turfster1/Spi2i2c2020-/images/DAUGHTERBOARD REV. 7 GREG VERSION.jpg

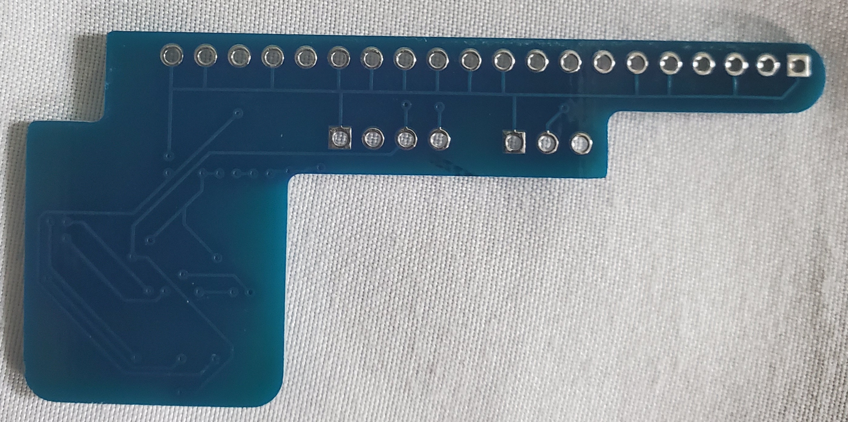
images/DAUGHTERBOARD REV. 7 GREG VERSION.jpg
