turfster1/Spi2i2c2020-/README.md

# Spi2i2c2020-
Open source recreation of the spi2par. However this new board  allows you to use slim character oled us2066 on the Xenium modchip for the OG Xbox. 

Thanks to everyone that helped.

This is for all original xbox enthusiasts to enjoy.

More to come soon.
