turfster1/Spi2i2c2020-/Arduinium/3D_New Arduinium 4 layer_2023-01-01emojiback.png

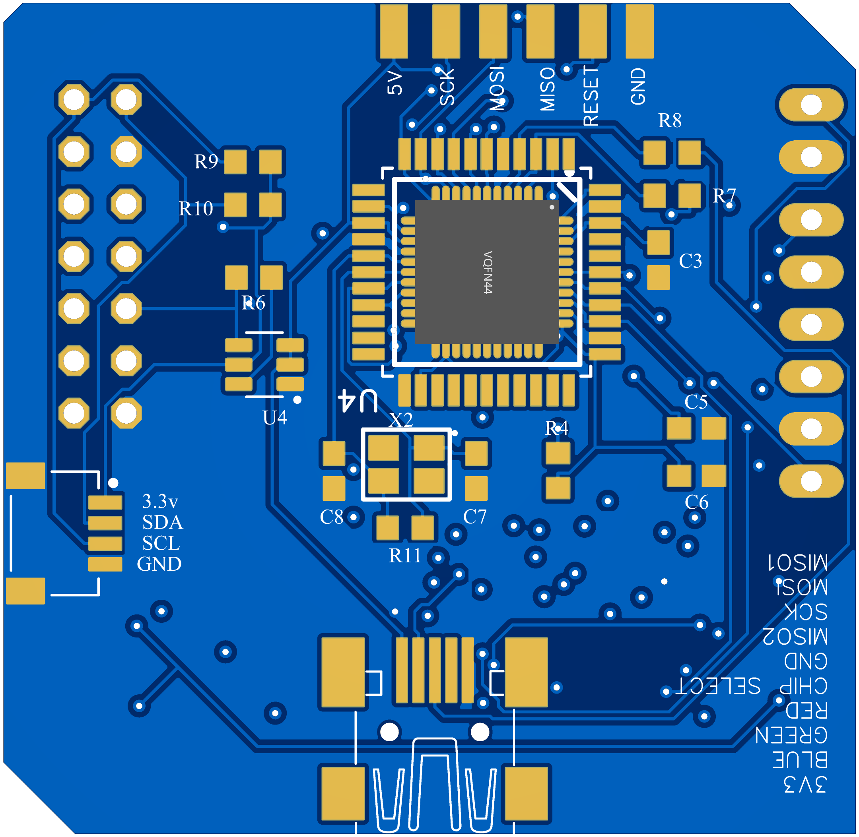
Arduinium/3D_New Arduinium 4 layer_2023-01-01emojiback.png
