turfster1/Spi2i2c2020-/Arduinium/Pics/3D_New Arduinium 4 layer_2023-01-01.png

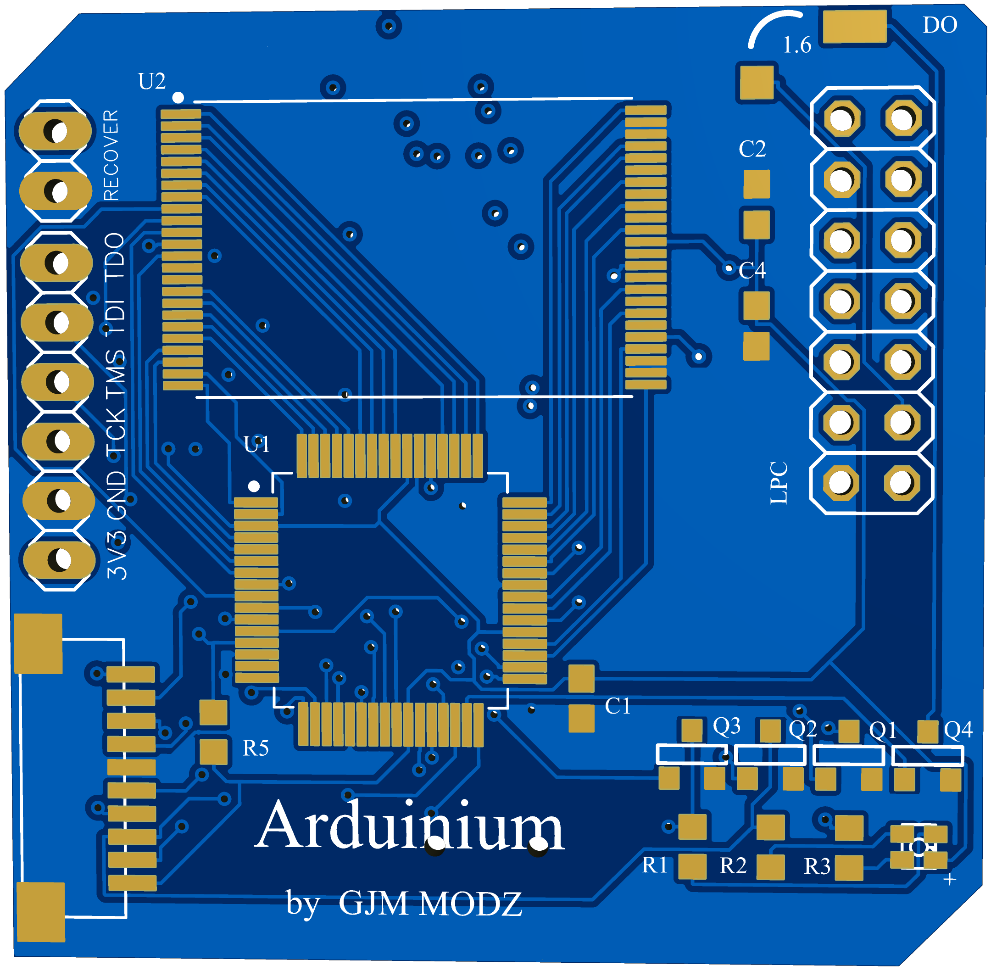
Arduinium/Pics/3D_New Arduinium 4 layer_2023-01-01.png
