turfster1/Spi2i2c2020-/Arduinium/Pics/3D_New Arduinium 4 layer_2024-02-11back.png

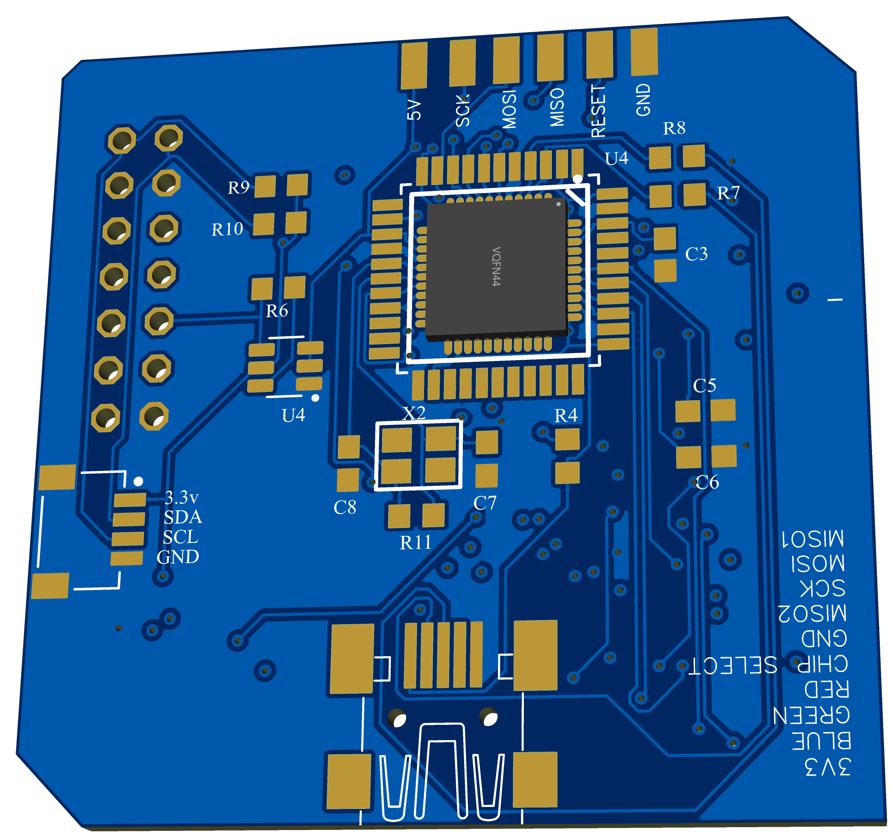
Arduinium/Pics/3D_New Arduinium 4 layer_2024-02-11back.png
