turfster1/Spi2i2c2020-/images/20201115_141857.jpg

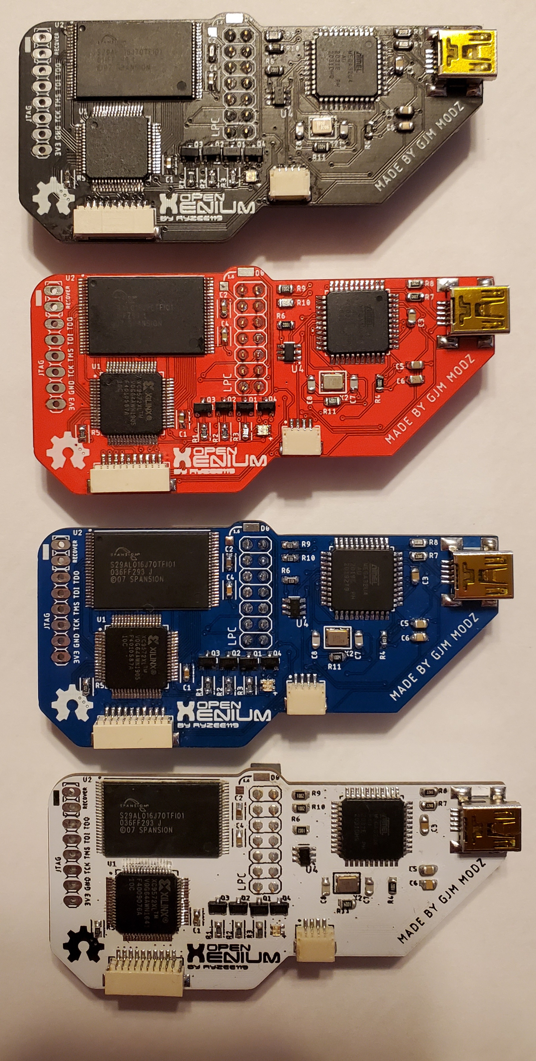
images/20201115_141857.jpg
