turfster1/Spi2i2c2020-/images/received_360769395019005.jpeg

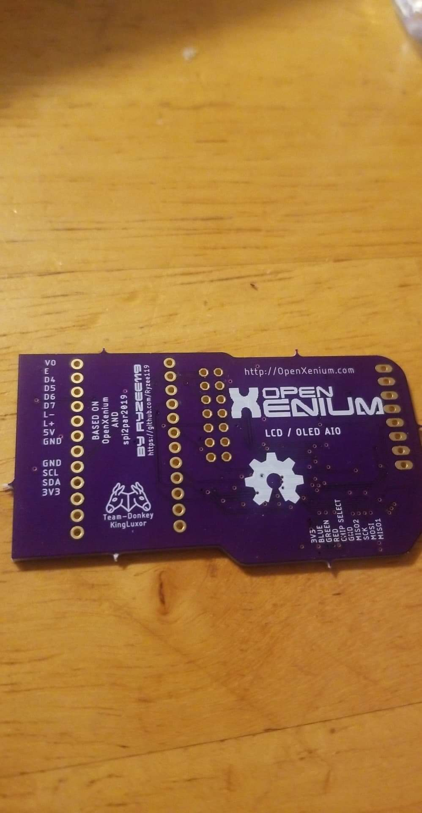
images/received_360769395019005.jpeg
