turfster1/Spi2i2c2020-/images/received_1338122879872721.jpeg

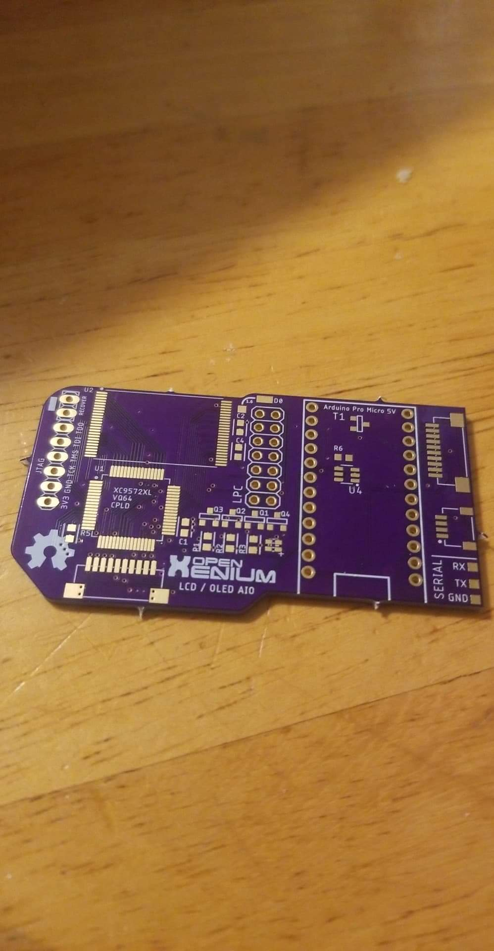
images/received_1338122879872721.jpeg
