turfster1/Spi2i2c2020-/images/VIRGIL PROOF THIS SIDE UP.jpg

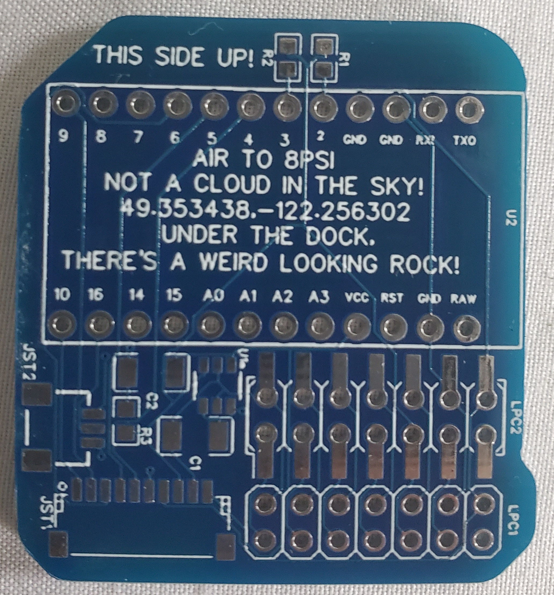
images/VIRGIL PROOF THIS SIDE UP.jpg
