turfster1/Spi2i2c2020-/images/VIRGIL PROOF.jpg

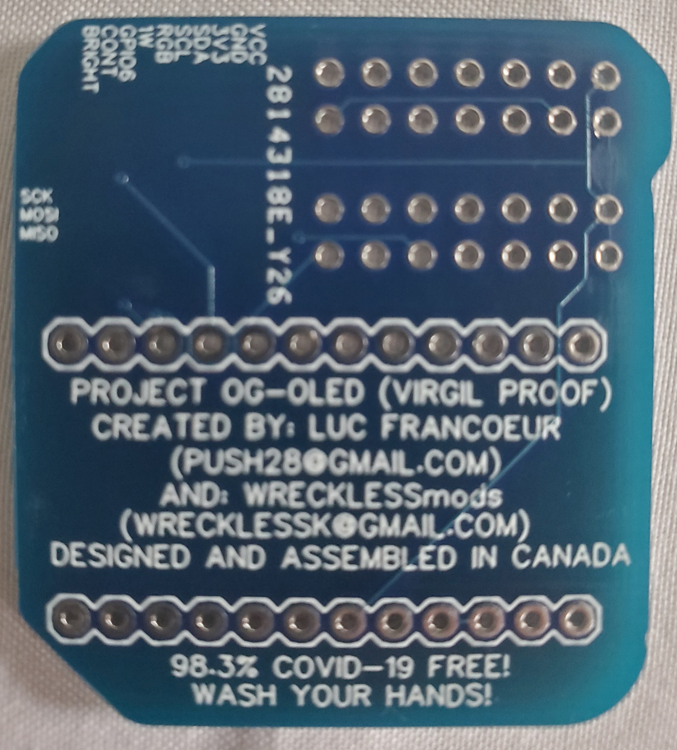
images/VIRGIL PROOF.jpg
