turfster1/Spi2i2c2020-/Oled Openxenium V1/Pics/top.png

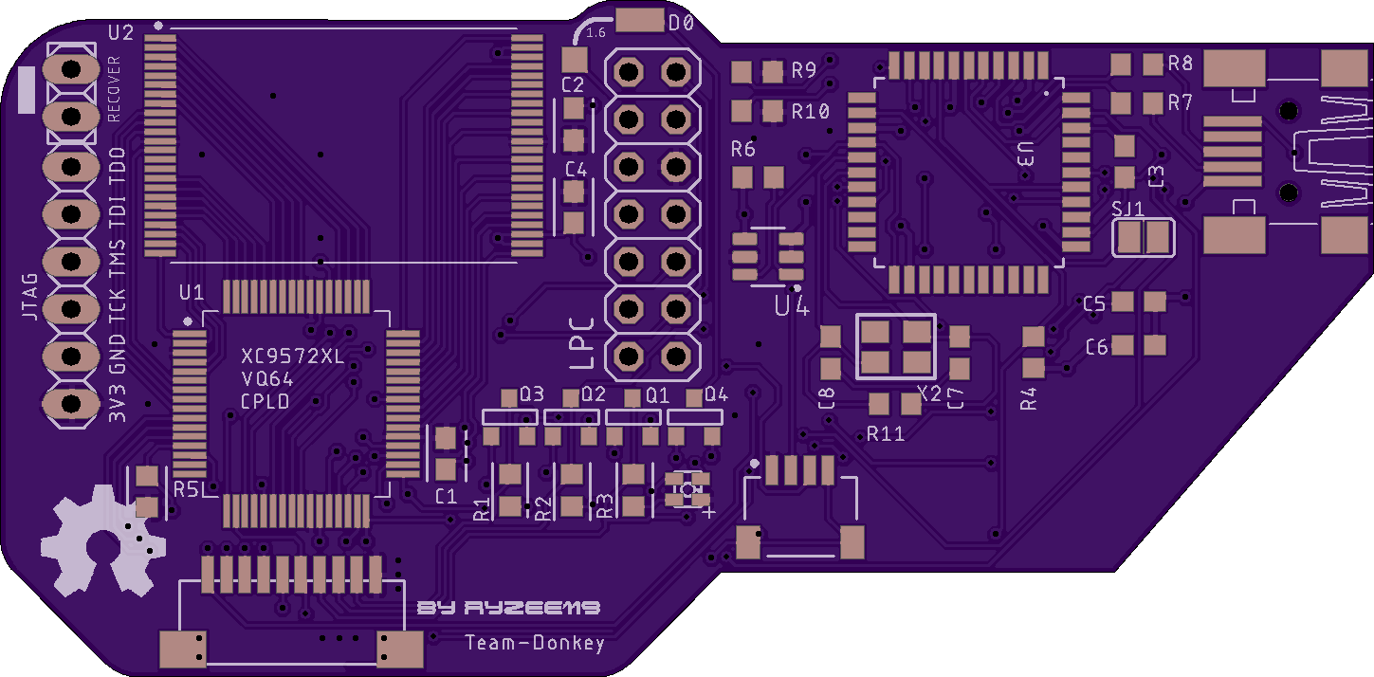
Oled Openxenium V1/Pics/top.png
