turfster1/Spi2i2c2020-/Oled Openxenium V1/Bom/Openxenium oled bom.docx

C1 22.61 11.94 270.00 100n C0603

C2 29.46 29.59 90.00 100n C0603

C3 58.98 27.60 270.00 100nF C0603

C4 29.46 25.15 270.00 10u C0603

C5 59.73 20.10 0.00 1uF C0603

C6 59.73 17.78 0.00 100nF C0603

C7 50.14 17.35 270.00 22pf C0603

C8 43.22 17.35 270.00 22pf C0603

D0 33.02 35.18 90.00 SMD1,27-2,54

J1 14.35 3.46 0.00 SM10B-SRSS-TB SM10B-SRSS-TB

J2 41.60 9.10 0.00 SM04B-SRSS-TB(LF)(SN) JST_SM04B-SRSS-TB(LF)(SN)

L1 35.56 10.03 0.00 19-237/R6GHBHC-A07/2T 4-SMD-R6GHBHC

Q1 32.61 13.91 180.00 310mA/60V/1.6Ω SOT-23

Q2 29.31 13.91 180.00 310mA/60V/1.6Ω SOT-23

Q3 26.01 13.91 180.00 310mA/60V/1.6Ω SOT-23

Q4 35.92 13.91 180.00 310mA/60V/1.6Ω SOT-23

R1 26.04 9.97 90.00 68 R0603

R10 39.28 30.28 0.00 10k R0603

R11 46.68 14.58 180.00 1M R0603

R2 29.34 9.97 90.00 68 R0603

R3 32.64 9.97 90.00 68 R0603

R4 54.10 17.36 90.00 10k R0603

R5 6.60 9.91 270.00 1k R0603

R6 39.33 26.74 0.00 10k R0603

R7 59.65 30.72 180.00 22r R0603

R8 59.65 32.81 180.00 22r R0603

R9 39.28 32.36 0.00 10k R0603

TP1 29.53 33.02 0.00 TPTP13SQ TP13SQ

U1 14.61 14.61 0.00 XC9572XL-10VQG64 LQFP64

U2 17.14 28.45 0.00 AM29LV160M TSOP48

U3 50.64 27.01 270.00 ATMEGA32U4-AU QFP80P1200X1200X120-44N

U4 39.84 22.51 180.00 TPS27081ADDCR SOT95P280X110-6N

X1 67.75 28.12 180.00 MINI-USB-32005-301 32005-301

X2 46.74 17.66 180.00 TSX-32250 TSX-3225
