turfster1/Spi2i2c2020-/Pcb protypes/Matts crazy idea/Parts for Virgil Proof, 2 OLED's with Daughterboards.xlsx

 | This list is for the PCB "Gerber_OGOLED_Virgil_Proof_Rev3-0_2020-05-03_21-44-02" with two OLED's,
 | in which each OLED uses a seperate "spi2i2c-daughterboard-rev7" daughterboard in any variant.
PCB Designator | Quantity Per Setup | Part Type | Manufacturer Part Number | Description | LCSC link | Aliexpress link | Digikey link
Elite U1 | 1 | SMD Integrated Circuit | TPS22929DDBVT or TPS22929DDBVR | Power Switch/Driver 1:1 P-Channel 1.8A SOT-23-6. | Click here to follow link. (https://lcsc.com/product-detail/PMIC-Power-Distribution-Switches_Texas-Instruments-Texas-Instruments-TPS22929DDBVR_C415177.html) | Click here to follow link. (https://www.aliexpress.com/item/32559103621.html) | Click here to follow link. (https://www.digikey.com/product-detail/en/texas-instruments/TPS22929DDBVT/296-30174-1-ND/2812728)
Elite U2 | 1 | Arduino |  | Pro Micro ATmega32U4 5V 16MHz Replace ATmega328 for Arduino Pro Mini With 2 Row Pin Header For Leonardo Mini Usb Interface. |  | Click here to follow link. (https://www.aliexpress.com/item/32864747086.html)
Elite R1,R2,R3 | 3 | SMD Resistor | RC0603JR-0710KL | SMD 10 kOhms ±5% 0.1W, 1/10W Chip Resistor 0603 (1608 Metric) Moisture Resistant Thick Film. | Click here to follow link. (https://lcsc.com/product-detail/Chip-Resistor-Surface-Mount_YAGEO-RC0603JR-0710KL_C99198.html) | Click here to follow link, select [10k]. (https://www.aliexpress.com/item/32867298442.html) | Click here to follow link, buying 10 costs less than buying 3. (https://www.digikey.com/product-detail/en/yageo/RC0603JR-0710KL/311-10KGRCT-ND/729647)
Elite C1 | 1 | SMD Capacitor | C1206C105M4RACTU or C1206C105M4RAC7800 | 1µF ±20% 16V Ceramic Capacitor X7R 1206 (3216 Metric). | Click here to follow link. (https://lcsc.com/product-detail/Multilayer-Ceramic-Capacitors-MLCC-SMD-SMT_KEMET-C1206C105M4RAC7800_C141188.html) | Click here to follow link, select [1uf(105) 100pcs]. (https://www.aliexpress.com/item/32375666910.html) | Click here to follow link. (https://www.digikey.com/product-detail/en/kemet/C1206C105M4RACTU/399-8150-1-ND/3471873)
Elite C2 | 1 | SMD Capacitor | C1206C104K3RACTU or TCC1206X7R104K250FT | 0.1µF (100NF) ±10% 25V Ceramic Capacitor X7R 1206 (3216 Metric). | Click here to follow link. (https://lcsc.com/product-detail/New-Arrivals_CCTC-TCC1206X7R104K250FT_C377064.html) | Click here to follow link, select [100NF(104) 100pcs]. (https://www.aliexpress.com/item/32375666910.html) | Click here to follow link. (https://www.digikey.com/product-detail/en/kemet/C1206C104K3RACTU/399-8140-1-ND/3471863)
Elite JST1 and both daughterboards J1, J2 | 5 | JST 10 pin Hybrid Male Connector | SM10B-SRSS-TB(LF)(SN) | Connector Header Surface Mount, Right Angle 10 position 0.039" (1.00mm). | Click here to follow link. (https://lcsc.com/product-detail/Wire-To-Board-Wire-To-Wire-Connector_JST-Sales-America-SM10B-SRSS-TB-LF-SN_C160409.html) | Click here to follow link. (https://www.aliexpress.com/item/4000475070318.html) | Click here to follow link. (https://www.digikey.com/product-detail/en/jst-sales-america-inc/SM10B-SRSS-TB(LF)(SN)/455-1810-1-ND/926881)
Elite JST2 | 1 | JST 3 pin Automotive Male Connector | SM03B-SRSS-TB(LF)(SN) | Connector Header Surface Mount, Right Angle 3 position 0.039" (1.00mm). | Click here to follow link. (https://lcsc.com/product-detail/Wire-To-Board-Wire-To-Wire-Connector_JST-Sales-America-SM03B-SRSS-TB-LF-SN_C160403.html) | Click here to follow link. (https://www.aliexpress.com/item/4000642368800.html) | Click here to follow link. (https://www.digikey.com/product-detail/en/jst-sales-america-inc/SM03B-SRSS-TB(LF)(SN)/455-1803-1-ND/926874)
Elite LPC1 | 1 | Header Male Connector | 67996-114HLF | 2.54mm Double Row Male 14P Breakaway PCB Board Pinheader. | Click here to follow link. (https://lcsc.com/product-detail/Pin-Header-Female-Header_Amphenol-ICC-67996-114HLF_C168681.html) | Click here to follow link, select [AU0.8] and [7P]. (https://www.aliexpress.com/item/4000310326374.html) | Click here to follow link. (https://www.digikey.com/product-detail/en/amphenol-icc-fci/67996-114HLF/609-3491-ND/1657807)
Elite LPC2 | 1 | SMT Female Header Socket | HLE-107-02-L-DV | Low Profile 2.54 mm Height 5.0mm Insulator 0.100" Pitch 2x7Pin Dual Row PCB Female Header Surface Mount No Posts. |  | Click here to follow link. (https://www.aliexpress.com/item/4000770441382.html) | Click here to follow link. (https://www.digikey.com/product-detail/en/samtec-inc/HLE-107-02-L-DV/SAM15658-ND/6693078)
Connects to Elite and daughterboards | 5 | JST 10 pin SH1.0 Housing Connector | SHR-10V-S-B | SH1.0 Housing 1.0mm Pitch Verticle 10 position Connector. | Click here to follow link. (https://lcsc.com/product-detail/Rectangular-Connectors-Housings_JST-Sales-America-SHR-10V-S-B_C394370.html) | Click here to follow link, select [10P]. (https://www.aliexpress.com/item/32883306474.html) | Click here to follow link. (https://www.digikey.com/product-detail/en/jst-sales-america-inc/SHR-10V-S-B/455-1385-ND/759874)
Connects to Elite | 1 | JST 3 pin SH1.0 Housing Connector | SHR-03V-S-B | SH1.0 Housing 1.0mm Pitch Verticle 3 position Connector. | Click here to follow link. (https://lcsc.com/product-detail/Rectangular-Connectors-Housings_JST-Sales-America-SHR-03V-S-B_C268100.html) | Click here to follow link, select [3P]. (https://www.aliexpress.com/item/32883306474.html) | Click here to follow link. (https://www.digikey.com/products/en?keywords=SHR-03V-S-B)
 | 4x 80mm, 4x 150mm, 4x 300mm | SH1.0 1.0mm Connector Wire |  | SH1.0 1.0mm Connector Wire Jst 28awg double Head. |  | Click here to follow link, select [Double Head]. (https://www.aliexpress.com/item/4000851005733.html)
 | ~ABOUT WIRING: The Aliexpress link can be used to purchase the three most commonly needed sizes, 80mm, 150mm and 300mm,
 | all in one color to save money. There are other wire colors available, but cost would be much more for multi colors.
 | ~Compare prices for the quantity you need, concider shipping. You should also compare other sources.
 | ~The header connectors can be purchased in 2x40 and cut down to 2x7.
 | There are also some single row headers that are colored, which can be side by side for 2x7.
