turfster1/Spi2i2c2020-/Stls/us2066 20x4 bezel v6 (1).stl

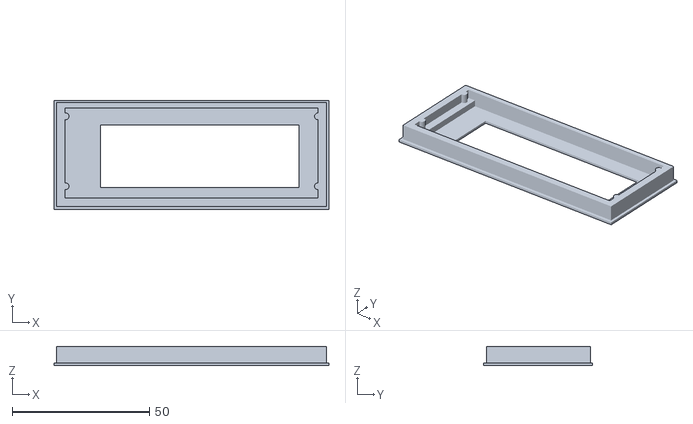
[picture p18: CAD file, 2024-02-17]
Stls/us2066 20x4 bezel v6 (1).stl
100.3 x 39.8 x 7.00
