turfster1/Spi2i2c2020-/install diagrams/Schematic_XeniumOLED-Rev1.6.pdf

## Xenium Modchip

# OLED Project

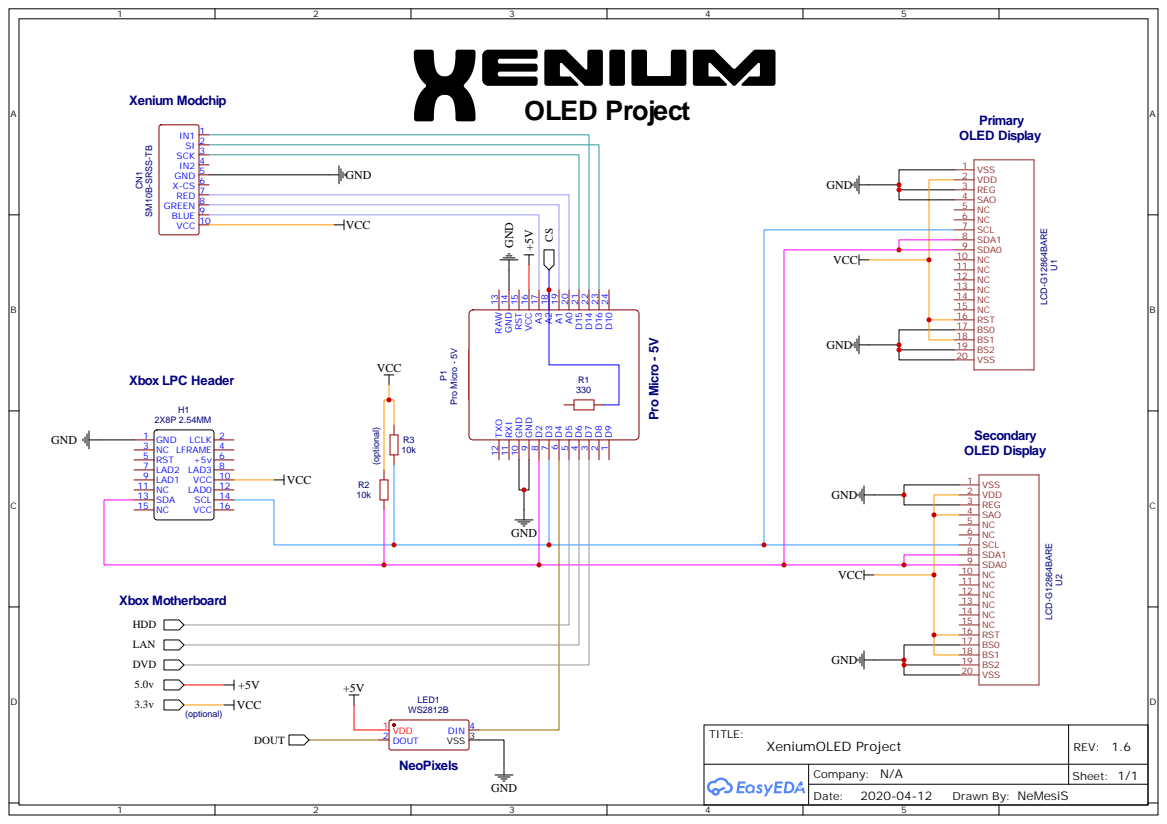
[picture p41: page 1]

9 GND 10 RXI 11 TXO 12 RAW 13 GND 14 RST 15 VCC 16
