turfster1/Spi2i2c2020-/Arduinium/Pics/PCB_New Arduinium 4 layer_2023-01-01.pdf

U2
C2

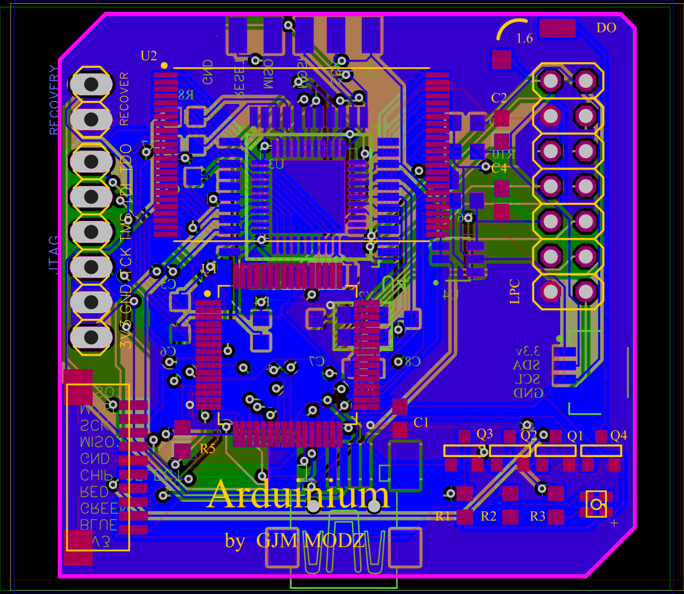
[picture p42: page 1]

RECOVER TDO TDI TMS TCK GND 3V3

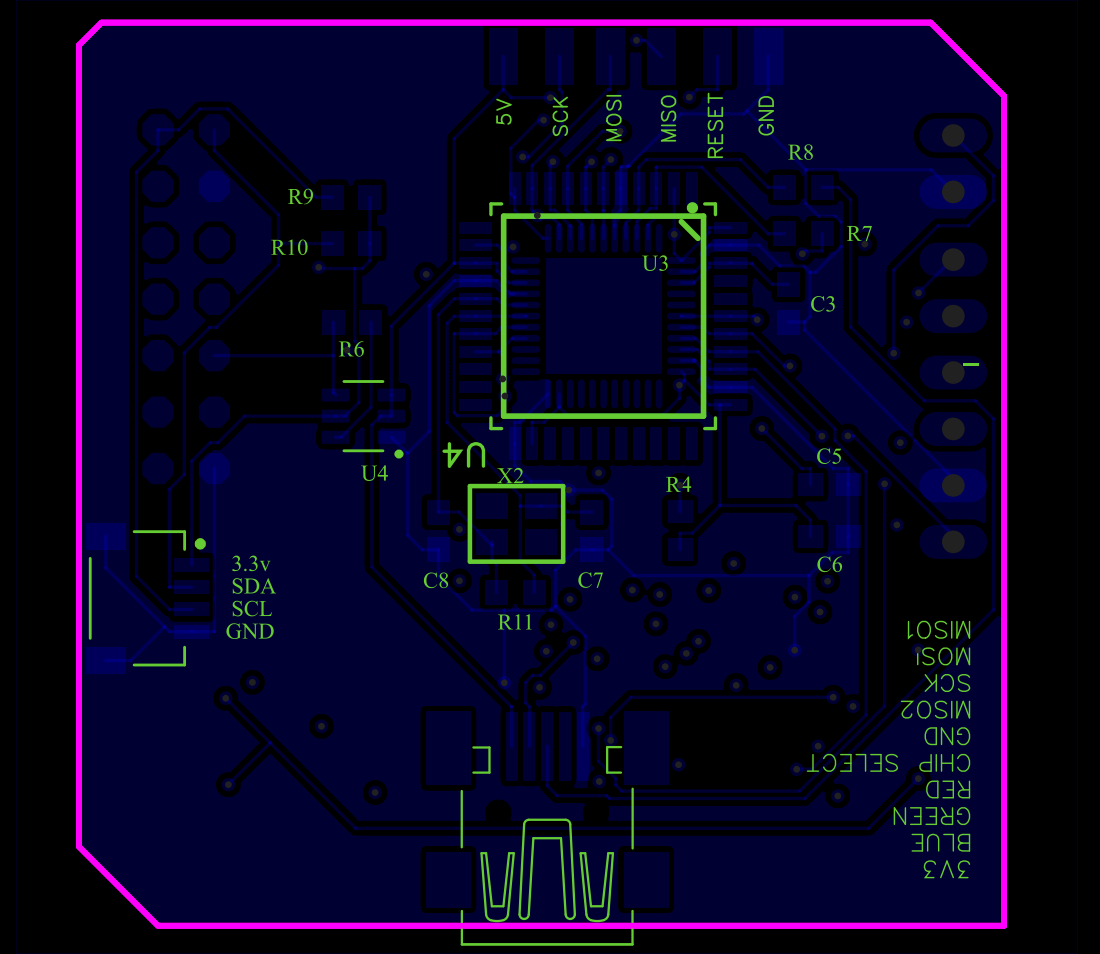
[picture p43: page 2]

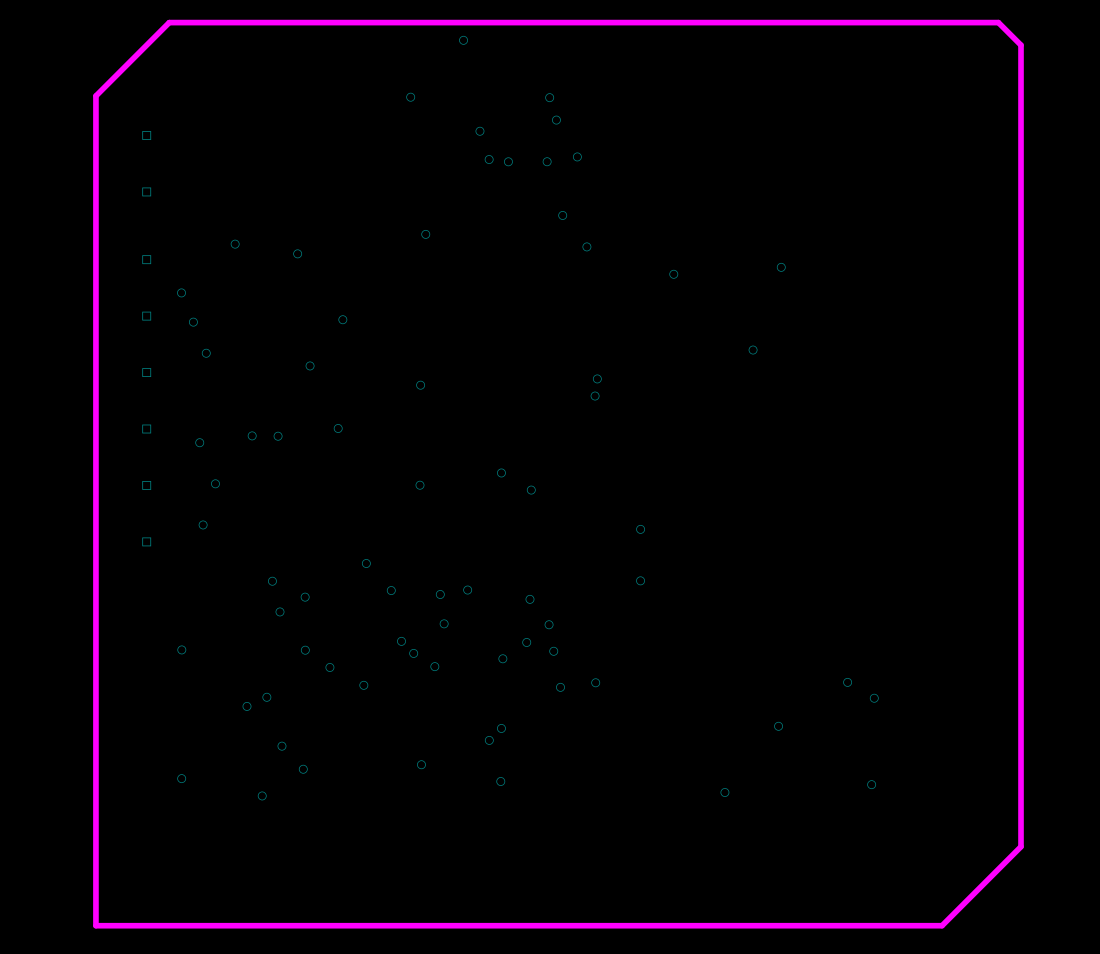
[picture p44: page 3]
