turfster1/Spi2i2c2020-/(commit log)

2023-12-22 Update and rename OpenXenium OLED V1 (3).csv to OpenXenium OLED V1.csv
    [OpenXenium OLED V1.csv]
2024-01-01 Add files via upload
    Same bom as oled openxenium v1
    [OpenXenium OLED V1.csv]
